stblassitude/blinkenarea-chaosknoten/manual/photos/switch.jpg

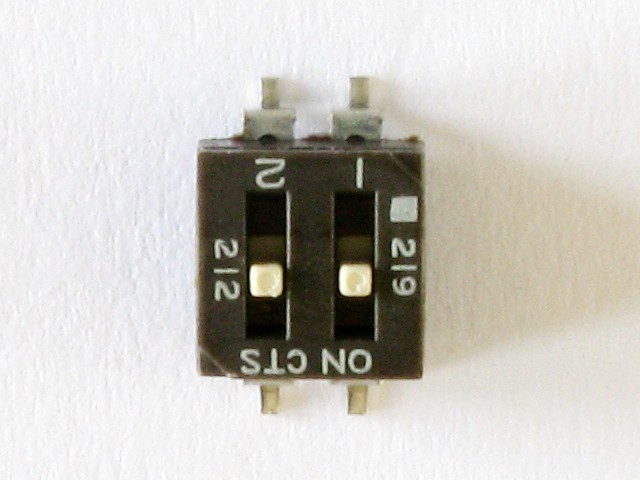
manual/photos/switch.jpg
