stblassitude/blinkenarea-chaosknoten/manual/photos/capacitor.jpg

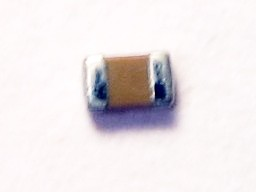
manual/photos/capacitor.jpg
