stblassitude/blinkenarea-chaosknoten/Chaosknoten.ods

Sheet: Chaosknoten part list
Chaosknoten – animated LED logo Version 1.0 date 2019-06-20 Copyright (C) 2019 Stefan Schuermans <stefan@blinkenarea.org> Copyleft: GNU public license - http://www.gnu.org/copyleft/gpl.html a BlinkenArea project - http://www.blinkenarea.org/
number | description | footprint | value | max. tolerance | symbols | vendor | vendor‘s part number | Reichelt's part number | R. brutto | DigiKey's part number | DK. netto (1 kit) | DK. brutto (1 kit) | DK. netto (100 kits) | DK. brutto (100 kits) | DK. netto (300 kits) | DK. brutto (300 kits) | min brutto (300 kits) | total
1 | printed circuit board | - | 65x50mm, 0.8mm FR4, 2 layers, 35um copper, Black solder-stop, no silkscreen print | - | - | custom | - | - | - | not from DigiKey | - | - | 2,67000 € | 3,17730 € | 1,24000 € | 1,47560 € | 1,47560 € | 1,47560 €
1 | battery holder | SMD | - | - | B1 | Keystone | 3002 | KZH 20SMD | 0,33000 € | BK-912-ND | 0,45000 € | 0,53550 € | 0,26950 € | 0,32071 € | 0,26950 € | 0,32071 € | 0,32071 € | 0,32071 €
1 | battery | 20mm round | 3V | - | for B1 | no soldered part | - | CR 2032 | 0,44000 € | - | 99,00000 € | 117,81000 € | 99,00000 € | 117,81000 € | 99,00000 € | 117,81000 € | 0,44000 € | 0,44000 €
1 | programming pads (no part) | 5 pads, 1.27mm | - | - | DBG1 | no part | - | - | 0,00000 € | - | 0,00000 € | 0,00000 € | 0,00000 € | 0,00000 € | 0,00000 € | 0,00000 € | 0,00000 € | 0,00000 €
1 | 2 pol DIP switch | SMD | - | - | S1 | CTS Electrocomponents | 219-2MST | - | 99,00000 € | CT2192MST-ND | 0,53000 € | 0,63070 € | 0,47000 € | 0,55930 € | 0,47000 € | 0,55930 € | 0,55930 € | 0,55930 €
1 | resistor | SMD 0805 | 10kE, >= 50mW | 5% | R1 | e.g. Yageo | e.g. RC0805FR-0710KL | SMD-0805 10,0K | 0,03000 € | 311-10.0KCRCT-ND | 0,09 | 0,10710 € | 0,01520 € | 0,01809 € | 0,01520 € | 0,01809 € | 0,01809 € | 0,01809 €
1 | ceramic capacitor | SMD 0805 | 100nF, >= 25V | -20%/+80% | C1 | e.g. Yageo | e.g. CC0805ZRY5V9BB104 | G0805-X7R 100N | 0,04000 € | 311-1361-1-ND | 0,12000 € | 0,14280 € | 0,03900 € | 0,04641 € | 0,03900 € | 0,04641 € | 0,04000 € | 0,04000 €
1 | logic level N-FET | SO-8 | IRF7402 | - | T1 | Infineon Technologies | IRF7402TRPBF | IRF 7401 | 0,70000 € | IRF7402PBFCT-ND | 0,93000 € | 1,10670 € | 0,58440 € | 0,69544 € | 0,58440 € | 0,69544 € | 0,69544 € | 0,69544 €
1 | microprocessor | SO-20 | ATtiny2313A | >= 8MHz @ 2.7V | IC1 | Microchip Technology | ATTINY2313A-SU | ATTINY 2313A-SU | 0,88000 € | ATTINY2313A-SU-ND | 1,00000 € | 1,19000 € | 0,83880 € | 0,99817 € | 0,83880 € | 0,99817 € | 0,88000 € | 0,88000 €
42 | LED orange | SMD | APL3015SECK-F01, orange | - | LED1-42 | Kingbright | APL3015SECK-F01 | - | 99,00000 € | 754-1110-1-ND | 0,23000 € | 0,27370 € | 0,07540 € | 0,08973 € | 0,06519 € | 0,07758 € | 0,07758 € | 3,25820 €
 |  |  |  |  |  |  |  |  |  |  |  |  |  |  |  |  |  | 7,68733 €

Sheet: Chaosknoten prices @1000
Chaosknoten – animated LED logo Version 1.0 date 2019-06-20 Copyright (C) 2019 Stefan Schuermans <stefan@blinkenarea.org> Copyleft: GNU public license - http://www.gnu.org/copyleft/gpl.html a BlinkenArea project - http://www.blinkenarea.org/
calculation for 1000 kits, 2020-01-01
number | description | footprint | value | max. tolerance | symbols | vendor | vendor‘s part number | Distributor | Distributor's part number | lead time | price (excl. VAT) | sum (excl. VAT) | total (incl. VAT)
1 | printed circuit board | - | 65x50mm, 0.8mm FR4, 2 layers, 35um copper, Black solder-stop, no silkscreen print | - | - | custom | - | multi-circuit-boards.eu | Chaosknoten-1.0 Nachbestellung - Art.-Nr.:534589 | 12 work days | 0,66000 € | 0,66000 €
1 | battery holder | SMD | - | - | B1 | MPD | BK-883 | digikey.de | BK-883-ND | in stock | 0,22226 € | 0,22226 €
1 | battery | 20mm round | 3V | - | for B1 | Everactive | 2032 | NEMT GmbH | Everactive 2032 | about 1 week | 0,10271 € | 0,10271 €
1 | programming pads (no part) | 5 pads, 1.27mm | - | - | DBG1 | no part | - | - | - | - | 0,00000 € | 0,00000 €
1 | 2 pol DIP switch | SMD | - | - | S1 | CTS Electrocomponents | 219-2MST | digikey.de | CT2192MST-ND | in stock | 0,34802 € | 0,34802 €
1 | resistor | SMD 0805 | 10kE, >= 50mW | 5% | R1 | any | - | digikey.de | CR0805-JW-103ELFCT-ND | in stock | 0,00285 € | 0,00285 €
1 | ceramic capacitor | SMD 0805 | 100nF, >= 25V | -20%/+80% | C1 | any | - | digikey.de | 399-1177-1-ND | in stock | 0,01270 € | 0,01270 €
1 | logic level N-FET | SO-8 | IRF7402 | - | T1 | Infineon Technologies | IRF7402TRPBF | mouser.de | 942-IRF7402TRPBF | in stock | 0,35500 € | 0,35500 €
1 | microprocessor | SO-20 | ATtiny2313A | >= 8MHz @ 2.7V | IC1 | Microchip Technology | ATTINY2313A-SU | digikey.de | ATTINY2313A-SU-ND | in stock | 0,80940 € | 0,80940 €
42 | LED orange | SMD | APL3015SECK-F01, orange | - | LED1-42 | Kingbright | APL3015SECK-F01 | digikey.de | 754-1110-2-ND | 9 weeks | 0,06479 € | 2,72118 €
 |  |  |  |  |  |  |  |  |  |  |  | 5,23412 € | 6,22860 €
