stblassitude/blinkenarea-chaosknoten/case/Fairydust.dxf

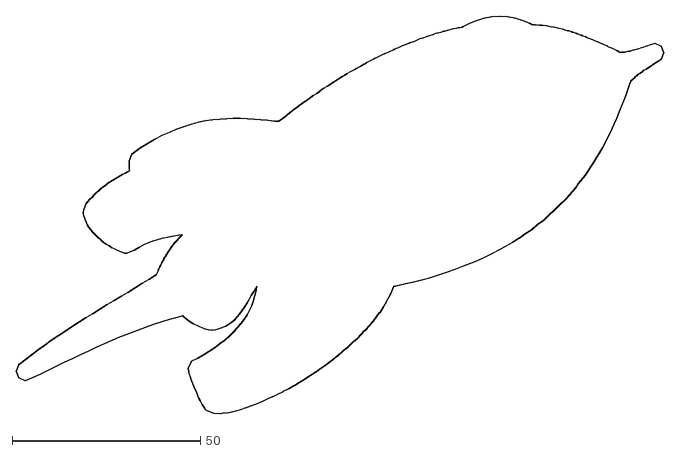
[picture p3: CAD file, 2021-10-19]
case/Fairydust.dxf
172.0 x 105.4
