stblassitude/blinkenarea-chaosknoten/Chaosknoten.dxf

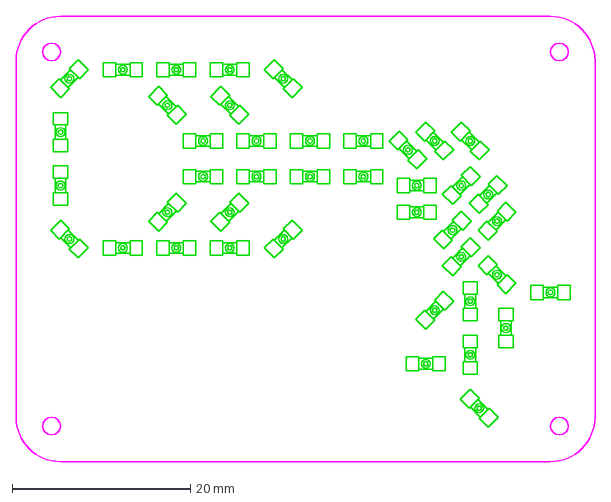
[picture p4: CAD file, 2019-05-16]
Chaosknoten.dxf
65.0 x 50.0 mm
