stblassitude/blinkenarea-chaosknoten/case/Chaosknoten-Case.stl

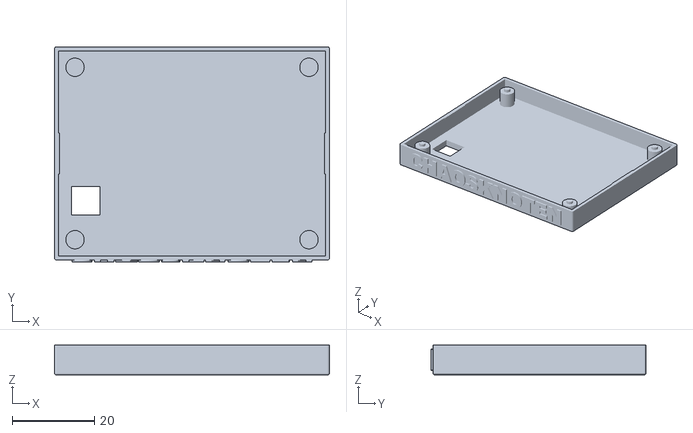
[picture p5: CAD file, 2021-10-19]
case/Chaosknoten-Case.stl
67.0 x 52.5 x 7.30
