stblassitude/blinkenarea-chaosknoten/(list of files, cad)

Other CAD files:
case/roundedcube.scad
