stblassitude/blinkenarea-chaosknoten/(list of files, drawings)

Other design files:
electrics/Chaosknoten.pcb
