stblassitude/blinkenarea-chaosknoten/manual/ChaosknotenOnePage.tex

\documentclass[a4paper]{minimal}
\usepackage[margin=0cm,landscape]{geometry}
\usepackage{graphicx}
\usepackage[utf8]{inputenc}
\pagestyle{empty}

\pdfinfo{
  /Title (Chaosknoten)
}

\begin{document}




\end{document}
