stblassitude/blinkenarea-chaosknoten/manual/photos/battery_holder.jpg

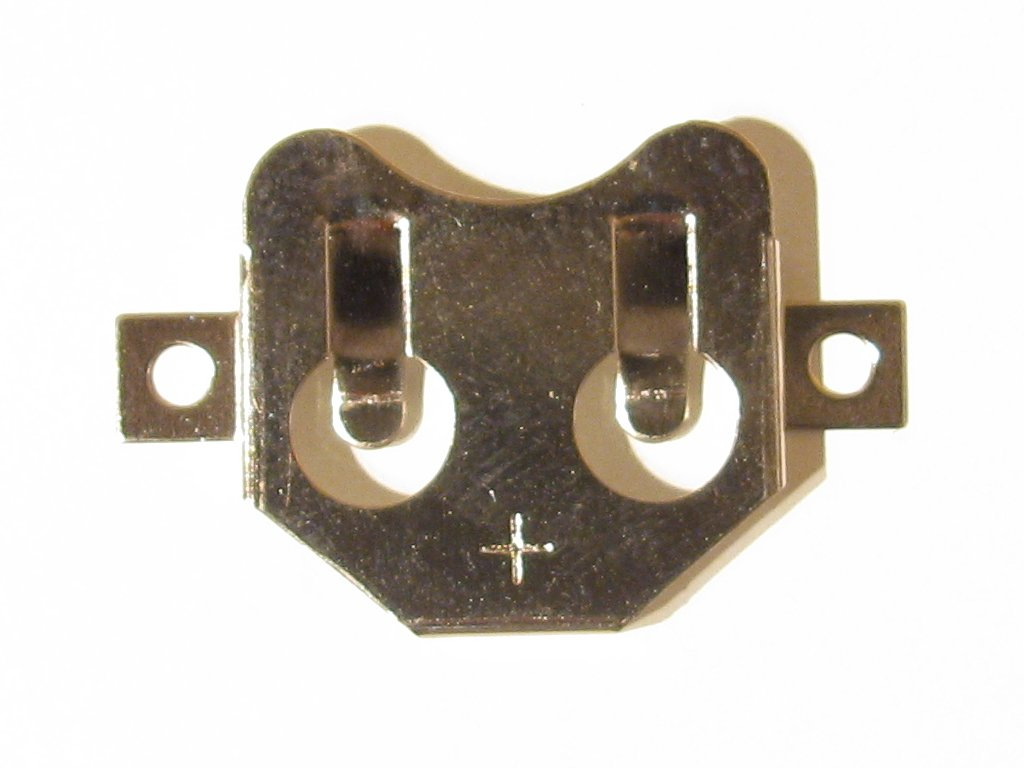
manual/photos/battery_holder.jpg
