stblassitude/blinkenarea-chaosknoten/manual/photos/Chaosknoten_back.jpg

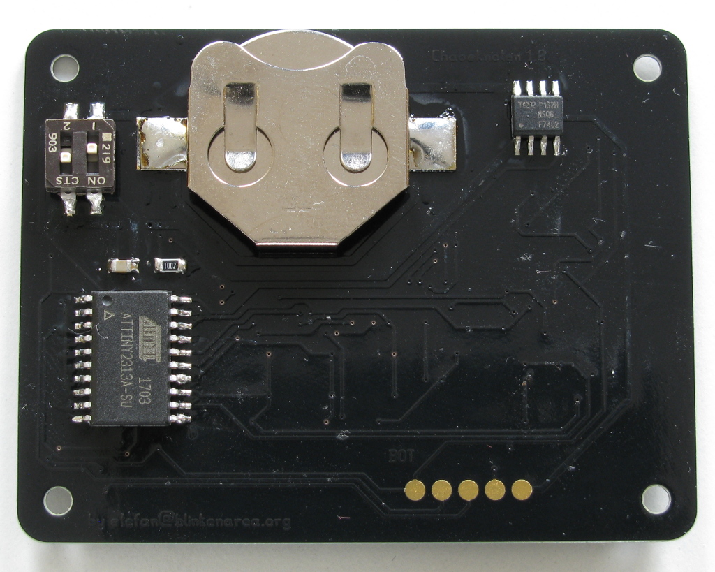
manual/photos/Chaosknoten_back.jpg
