stblassitude/blinkenarea-chaosknoten/manual/photos/Chaosknoten_front.jpg

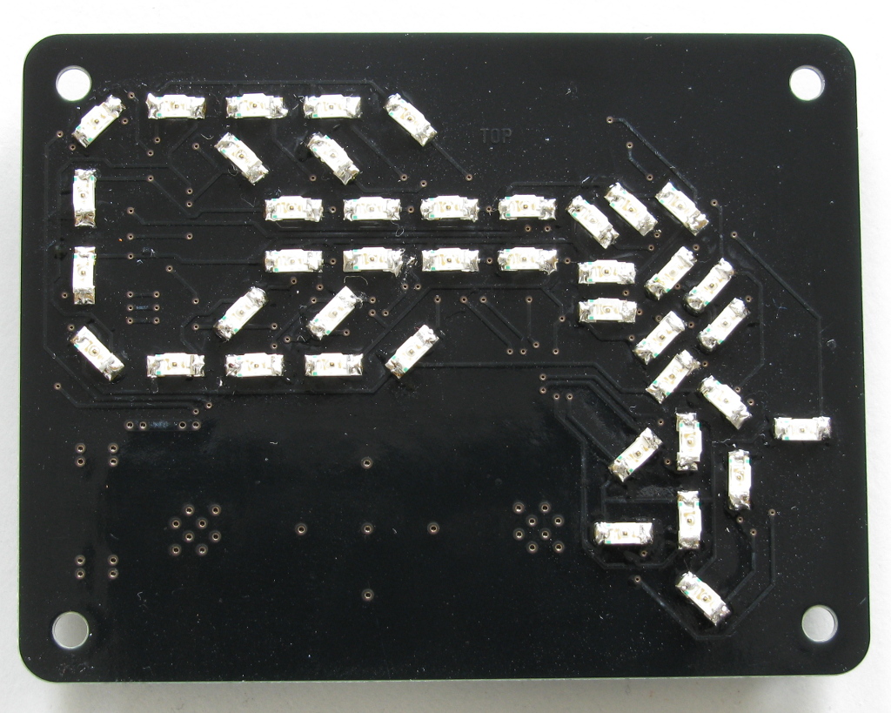
manual/photos/Chaosknoten_front.jpg
