stblassitude/blinkenarea-chaosknoten/manual/photos/led.jpg

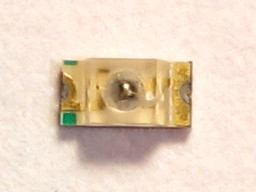
manual/photos/led.jpg
