stblassitude/blinkenarea-chaosknoten/manual/photos/microcontroller.jpg

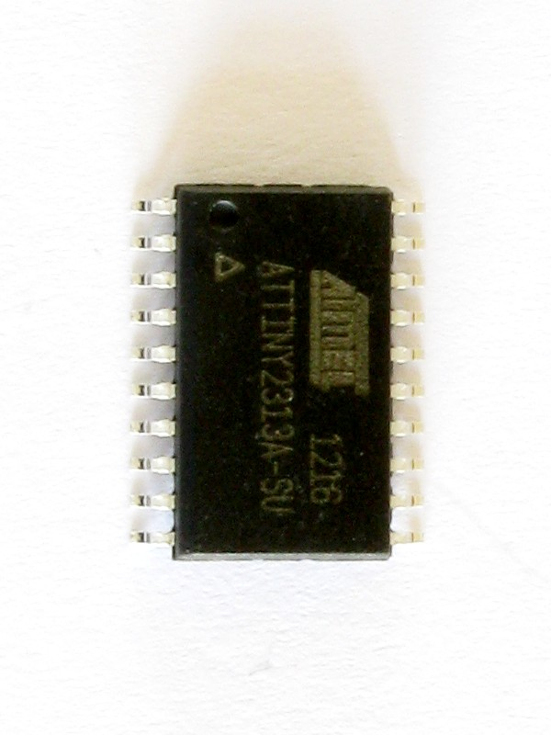
manual/photos/microcontroller.jpg
