stblassitude/blinkenarea-chaosknoten/manual/photos/resistor.jpg

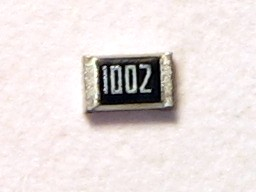
manual/photos/resistor.jpg
