stblassitude/blinkenarea-chaosknoten/manual/photos/transistor.jpg

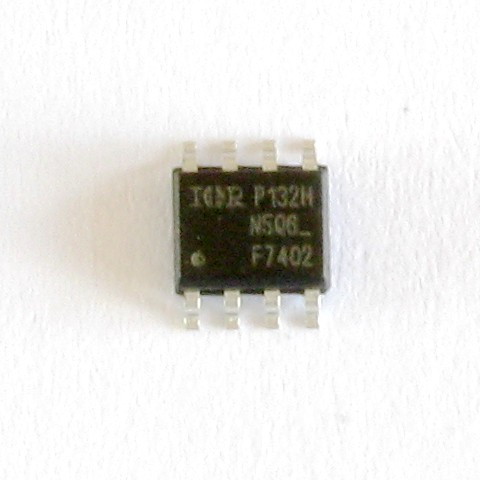
manual/photos/transistor.jpg
