stblassitude/blinkenarea-chaosknoten/(commit log)

2019-05-09 initial checkin of Chaosknoten
    [Chaosknoten.dxf, Chaosknoten.pcb, Chaosknoten.sch]
2019-05-12 electrics subdir
    [Chaosknoten.pcb, Chaosknoten.sch]
2019-05-12 small beautifications
    [Chaosknoten.pcb]
2019-05-12 vias in switch pads
    [Chaosknoten.pcb]
2019-05-12 add round corners, fix bottom right hole
    [Chaosknoten.pcb]
2019-05-16 add lights to DXF
    [Chaosknoten.dxf]
2019-05-16 add text to PCB, add vias to battery pad
    [Chaosknoten.pcb]
2019-05-18 part list, prices
    [Chaosknoten.ods]
2019-05-19 gerber data V 1.0
    [Chaosknoten.pcb, Chaosknoten.sch]
2019-06-16 minor text fix of part list
    [Chaosknoten.ods]
2019-06-16 add vendor / vendor part no
    [Chaosknoten.ods]
2019-06-20 price calculation for 300x
    [Chaosknoten.ods]
2019-06-21 fix polarity in LED picture, fix typos
2019-06-21 LED positions for Blimp template
2019-06-22 frame time unit is 6 ms
2019-06-22 movie compression, add another movie
    add movie compression: run length encoding (if shorter than plain frame) and
    refer to previous frames if frames repeat,
    add breathe movie
    [Chaosknoten.asm, bbm2Chaosknoten.py]
2019-06-22 remove debug print
2020-01-01 calculation for 1000 kits
    [Chaosknoten.ods]
2021-10-19 Add case for PCB
    [Chaosknoten-Case.scad, Chaosknoten-Case.stl, Fairydust.dxf, roundedcube.scad]
